AllenNeuralDynamics/harp.device.treadmill/hardware/board/treadmill_linear_brake_driver.asc

B1: bv; V=V(Vsns+, Vsns-)*200
C1: cap; 10n
D1: diode
L1: ind; 1m
M1: nmos; Si7336ADP
R1: res; 10
R2: res; 80m
R3: res; 7.5k
R4: res; 115
R6: res; 5.1k
U1: UniversalOpamp2; Avol=1.5Meg GBW=24Meg Slew=12Meg
V1: voltage; 12
V2: voltage; PULSE(.8 1.6 2m 100u 100u 200u 200u 4)
V3: voltage; 5
Named nets: 0, Vsns+, Vsns-, +5V
INA180A4 Simplified Model
.tran 50m startup
Brake model
DAC from MCU
for setpoint
