AllenNeuralDynamics/harp.device.treadmill/hardware/board/harp_treadmill.kicad_pcb

## KiCad design hardware/board/harp_treadmill.kicad_pcb (2025-09-08)

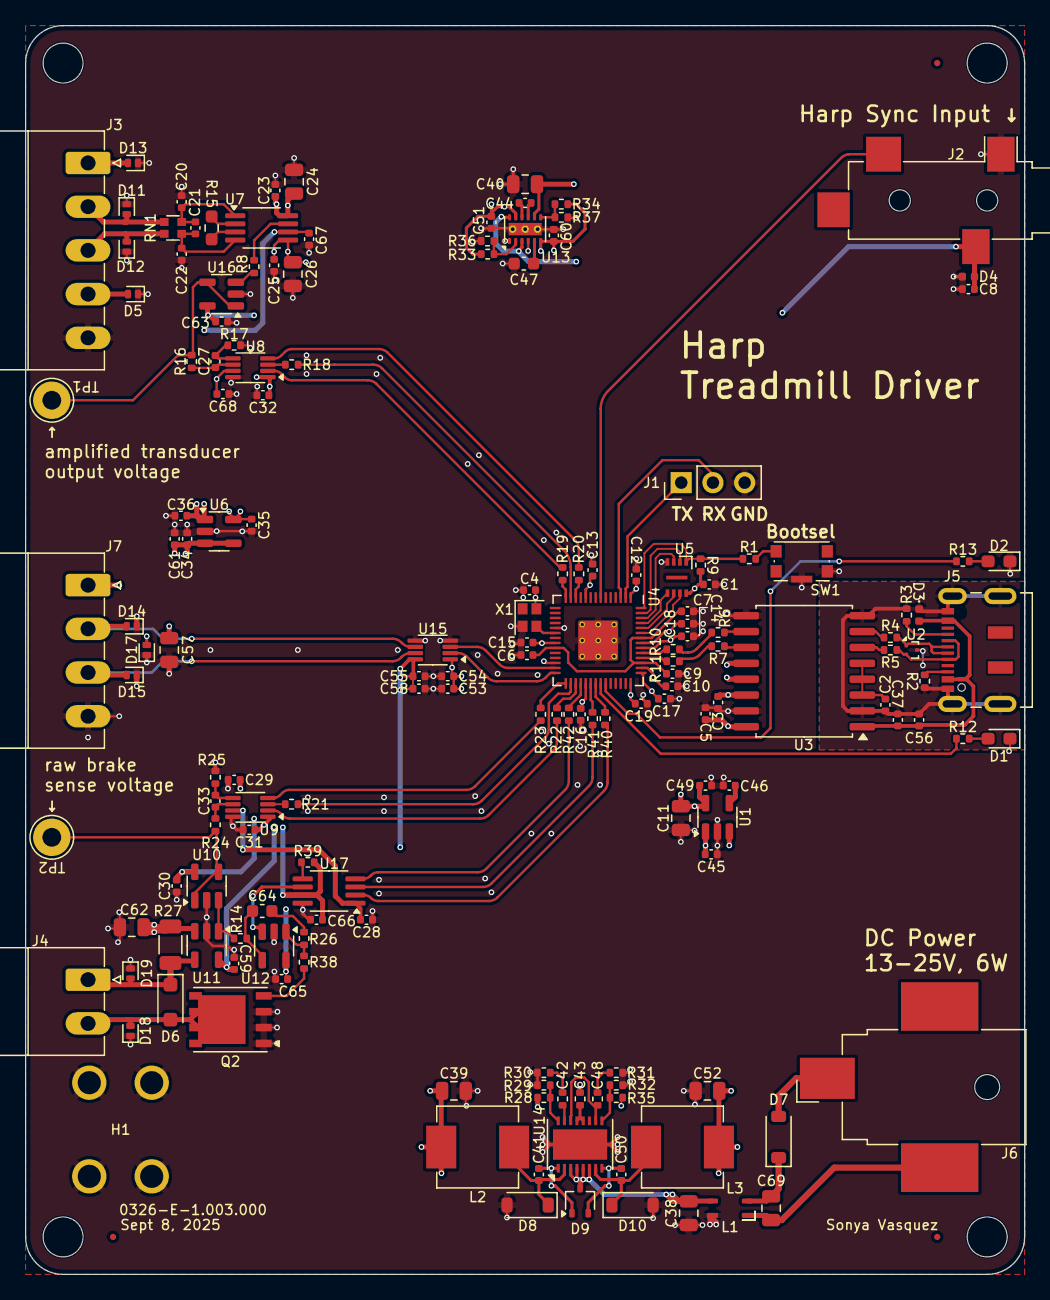
[picture p1: board harp_treadmill.kicad_pcb from above]

Board: 4 copper layers, 80.0 x 100.0 mm, 166 parts (0 on the bottom side), 105 nets.

Parts:
C1, C2, C3, C5, C6, C7, C12, C13, C14, C15, C16, C17, C18, C19, C23, C25, C28, C29, C30, C31, C32, C34, C35, C36, C37, C41, C50, C53, C58, C59, C63, C65, C66, C67, C68: 100nF; C_0402_1005Metric
C4, C46: 10nF; C_0402_1005Metric
C8, C9, C10, C44, C45, C54, C55, C56, C61: 1uF; C_0402_1005Metric
C11, C24, C26, C38, C57, C62, C69: 10uF; C_0805_2012Metric
C20, C22: 100pF; C_0402_1005Metric
C21: 1000pF; C_0402_1005Metric
C27, C33: 300pF; C_0402_1005Metric
C39, C40, C52: 22uF; C_0805_2012Metric
C42, C48: 1.5nF; R_0402_1005Metric
C43: 4.7nF; R_0402_1005Metric
C47: 4.7uF; C_0603_1608Metric
C49, C51, C60: 2.2uF; C_0402_1005Metric
C64: 10nF; C_0603_1608Metric
D1, D2: LED; LED_0603_1608Metric_Pad1.05x0.95mm_HandSolder
D3, D4: D_TVS; D_0402_1005Metric
D5, D11, D12, D13, D14, D15, D17, D18, D19: D_TVS; D_SOD-882D
D6: 1N4007FL; D_SOD-123F
D7, D8, D10: D_Schottky; D_SOD-123
D9: BAT54AW; SOT-323_SC-70
FID1, FID2, FID3: Fiducial; Fiducial_0.5mm_Mask1mm
H1: MountingHole_Pad; Terminal_Keystone_779x_EdgeMount_Horizontal
J1: Conn_01x03_Male; PinHeader_1x03_P2.54mm_Vertical
J2: AudioJack3; Jack_3.5mm_CUI_SJ-3524-SMT_Horizontal
J3: Conn_01x05_Female; PhoenixContact_MC_1,5_5-G-3.5_1x05_P3.50mm_Horizontal
J4: Conn_01x02_Female; PhoenixContact_MC_1,5_2-G-3.5_1x02_P3.50mm_Horizontal
J5: USB_C_Receptacle_USB2.0; USB_C_Receptacle_JAE_DX07S016JA1R1500
J6: Barrel_Jack_Switch; BarrelJack_CUI_PJ-036AH-SMT_Horizontal
J7: Conn_01x04_Female; PhoenixContact_MC_1,5_4-G-3.5_1x04_P3.50mm_Horizontal
L1: L_Coupled_1423; L_CommonModeChoke_TDKCorporation_1210
L2, L3: 10uH; L_Vishay_IHLP-2525
Q2: Si7336ADP; PowerPAK_SO-8_Single
R1: 1K; R_0402_1005Metric
R2, R3, R26: 5K1; R_0402_1005Metric
R4, R5, R6, R7: 24; R_0402_1005Metric
R8, R9, R28, R30, R31, R35, R39: 10K; R_0402_1005Metric
R10, R11: 27; R_0402_1005Metric
R12, R13: 680; R_0402_1005Metric
R14: 7K5; R_0402_1005Metric
R15: 499; R_0603_1608Metric_Pad0.98x0.95mm_HandSolder
R16, R17, R24, R25: 100; R_0402_1005Metric
R18, R19, R20, R21, R22, R23, R40, R41, R42: 49.9; R_0402_1005Metric
R27: 0.08; R_1206_3216Metric
R29: 715; R_0402_1005Metric
R32: 1K82; R_0402_1005Metric
R33: 162K; R_0402_1005Metric
R34: 158K; R_0402_1005Metric
R36, R37: 51K; R_0402_1005Metric
R38: 10; R_0402_1005Metric
RN1: 20K; R_Array_Convex_2x0606
SW1: SW_Push_1P1T-SH_NO_Vertical_Wuerth_WS-TASV
TP1, TP2: TestPoint; TestPoint_THTPad_D3.0mm_Drill1.5mm
U1: LP2985-3.3; SOT-23-5
U2: TPD2EUSB30; Texas_DRT-3
U3: ADUM4160; SOIC-16W_7.5x10.3mm_P1.27mm
U4: RP2040; RP2040-QFN-56
U5: W25Q16JVUXIQ; Winbond-8USON-2x3mm
U6: REF2033; SOT-23-5
U7: AD8226; MSOP-8_3x3mm_P0.65mm
U8, U9: ADS7049; VSSOP-8_2.3x2mm_P0.5mm
U10, U12, U16: AD8615; TSOT-23-5
U11: INA180A4; SOT-23-5
U13: LM27762; WSON-12-1EP_3x2mm_P0.5mm_EP1x2.65_ThermalVias
U14: LT3506; DFN-16-1EP_4x5mm_P0.5mm_EP2.44x4.34mm
U15: 74LVCH2T45DC; VSSOP-8_2.3x2mm_P0.5mm
U17: LTC2641; MSOP-8_3x3mm_P0.65mm
X1: ECS-TXO-2016; Crystal_SMD_2016-4Pin_2.0x1.6mm

Connections:
5V2: C34.2, C40.1, C45.1, C52.1, C55.1, C57.1, C58.2, C61.1, C65.2, D17.2 (A2), J7.1, L3.2, R35.1, U1.1 (VIN), U1.3 (ON/~OFF), U6.3 (EN), U6.4 (VIN), U12.5 (V+), U13.3 (VIN), U13.8 (EN-), U13.12 (EN+), U15.8 (VCCB)
+1V1: C6.2, C7.2, C9.1, U4.23 (DVDD), U4.45 (VREG_VOUT), U4.50 (DVDD)
+3V3: C1.2, C3.2, C4.2, C5.2, C8.1, C10.1, C11.1, C12.2, C13.2, C14.2, C15.2, C16.2, C17.2, C18.2, C19.2, C30.2, C31.2, C32.2, C49.2, C53.2, C54.1, C59.2, C63.2, C66.2, D4.2 (A2), J2.R, R9.2, R39.2, U1.5 (VOUT), U3.12 (PIN), U3.13 (SPD), U3.14 (VDD2), U3.16 (VBUS2), U4.1 (IOVDD), U4.10 (IOVDD), U4.22 (IOVDD), U4.26 (RUN), U4.33 (IOVDD), U4.42 (IOVDD), U4.43 (ADC_AVDD), U4.44 (VREG_IN), U4.48 (USB_VDD), U4.49 (IOVDD), U5.8 (VCC), U8.1 (DVDD), U9.1 (DVDD), U10.5 (V+), U11.5 (V+), U15.1 (VCCA), U16.5 (V+), U17.7 (VDD), X1.4 (VDD)
+5V: C23.2, C24.1, C51.2, D13.2 (A2), J3.1, R33.1, U7.8 (V+), U13.11 (OUT+)
+12V: C39.1, C62.1, L2.1, R27.1, R28.2, U11.3 (+)
-5V: C25.2, C26.2, C60.2, D5.2 (A2), J3.4, R34.1, U7.5 (V-), U13.6 (OUT-)
/Encoder/ENC_A: U4.27 (GPIO16), U15.3 (2A)
/Encoder/ENC_B: U4.28 (GPIO17), U15.2 (1A)
/Harp Core RP2040 + Isolated USB/D+: J5.A6 (D+), J5.B6 (D+), R4.1, U2.1 (D+)
/Harp Core RP2040 + Isolated USB/D-: J5.A7 (D-), J5.B7 (D-), R5.1, U2.2 (D-)
/Harp Core RP2040 + Isolated USB/DD+: R6.2, R10.2
/Harp Core RP2040 + Isolated USB/DD-: R7.2, R11.2
/Harp Core RP2040 + Isolated USB/HARP_CLK_SYNC: J2.T, U4.7 (GPIO5)
/Harp Core RP2040 + Isolated USB/PIO_ADC0_CS: R23.2, U4.29 (GPIO18)
/Harp Core RP2040 + Isolated USB/PIO_ADC0_POCI: R21.2, U4.30 (GPIO19)
/Harp Core RP2040 + Isolated USB/PIO_ADC0_SCK: R22.2, U4.31 (GPIO20)
/Harp Core RP2040 + Isolated USB/PIO_ADC1_CS: R20.2, U4.12 (GPIO9)
/Harp Core RP2040 + Isolated USB/PIO_ADC1_POCI: R18.2, U4.13 (GPIO10)
/Harp Core RP2040 + Isolated USB/PIO_ADC1_SCK: R19.2, U4.14 (GPIO11)
/Harp Core RP2040 + Isolated USB/PIO_DAC_CS: R40.2, U4.35 (GPIO23)
/Harp Core RP2040 + Isolated USB/PIO_DAC_PICO: R42.2, U4.32 (GPIO21)
/Harp Core RP2040 + Isolated USB/PIO_DAC_SCK: R41.2, U4.34 (GPIO22)
/Harp Core RP2040 + Isolated USB/QSPI_CLK: U4.52 (QSPI_SCLK), U5.6 (CLK)
/Harp Core RP2040 + Isolated USB/QSPI_CS: R1.2, R9.1, U4.56 (QSPI_SS), U5.1 (~CS)
/Harp Core RP2040 + Isolated USB/QSPI_D0: U4.53 (QSPI_SD0), U5.5 (DI(IO0))
/Harp Core RP2040 + Isolated USB/QSPI_D1: U4.55 (QSPI_SD1), U5.2 (DO(IO1))
/Harp Core RP2040 + Isolated USB/QSPI_D2: U4.54 (QSPI_SD2), U5.3 (IO2)
/Harp Core RP2040 + Isolated USB/QSPI_D3: U4.51 (QSPI_SD3), U5.7 (IO3)
/Harp Core RP2040 + Isolated USB/UART0_RXD: J1.2, U4.3 (GPIO1)
/Harp Core RP2040 + Isolated USB/UART0_TXD: J1.1, U4.2 (GPIO0)
/Harp Core RP2040 + Isolated USB/USB_Boot: R1.1, SW1.2
/Harp Core RP2040 + Isolated USB/VDD1: C2.2, U3.3 (VDD1), U3.4 (PDEN), U3.5 (SPU)
GND: C1.1, C3.1, C4.1, C5.1, C6.1, C7.1, C8.2, C9.2, C10.2, C11.2, C12.1, C13.1, C14.1, C15.1, C16.1, C17.1, C18.1, C19.1, C20.1, C22.2, C23.1, C24.2, C25.1, C26.1, C28.1, C29.1, C30.1, C31.1, C32.1, C34.1, C35.1, C36.1, C38.2, C39.2, C40.2, C43.1, C45.2, C46.2, C47.2, C49.1, C51.1, C52.2, C53.1, C54.2, C55.2, C57.2, C58.1, C59.1, C60.1, C61.2, C62.2, C63.1, C65.1, C66.1, C67.1, C68.1, D1.1 (K), D2.1 (K), D4.1 (A1), D5.1 (A1), D8.2 (A), D10.2 (A), D11.1 (A1), D12.1 (A1), D13.1 (A1), D14.1 (A1), D15.1 (A1), D17.1 (A1), D18.1 (A1), D19.1 (A1), H1.1, J1.3, J2.S, J3.5, J7.4, L1.4, Q2.1 (S), Q2.2 (S), Q2.3 (S), R17.1, R25.1, R29.2, R30.1, R31.1, R32.1, R36.2, R37.2, SW1.4, SW1.SH, U1.2 (GND), U3.9 (GND2), U3.15 (GND2), U4.19 (TESTEN), U4.57 (GND), U5.4 (GND), U6.2 (GND), U8.8 (GND), U9.8 (GND), U10.2 (V-), U11.2 (GND), U12.2 (V-), U13.1 (PGOOD), U13.4 (GND), U13.13 (PAD), U14.17 (GND), U15.4 (GND), U15.5 (DIR), U16.2 (V-), U17.8 (GND), X1.2 (GND)
GND1: C2.1, C37.1, C56.2, D3.1 (A1), J5.A1 (GND), J5.A12 (GND), J5.B1 (GND), J5.B12 (GND), J5.S1 (SHIELD), R2.2, R3.2, U2.3 (GND), U3.2 (GND1), U3.8 (GND1)
GND2: C69.2, J6.2, L1.1
unnamed: C42.1, R30.2
unnamed: C48.2, R31.2
unnamed: C64.2, R26.1
unnamed: D1.2 (A), R12.2
unnamed: D2.2 (A), R13.2
unnamed: C69.1, D7.1 (K), L1.2
unnamed: C41.1, D8.1 (K), L2.2, U14.2 (SW1)
unnamed: C50.1, D10.1 (K), L3.1, U14.7 (SW2)
unnamed: D11.2 (A2), J3.2, RN1.1 (R1.1)
unnamed: D12.2 (A2), J3.3, RN1.2 (R2.1)
unnamed: D14.2 (A2), J7.2, U15.6 (2B)
unnamed: D15.2 (A2), J7.3, U15.7 (1B)
unnamed: D6.2 (A), D18.2 (A2), J4.2, Q2.5 (D)
unnamed: D6.1 (K), D19.2 (A2), J4.1, R27.2, U11.4 (-)
unnamed: J5.A5 (CC1), R2.1
unnamed: J5.B5 (CC2), R3.1
unnamed: Q2.4 (G), R38.2
unnamed: R15.1, U7.2 (RG)
unnamed: R15.2, U7.3 (RG)
unnamed: R26.2, R38.1, U12.1
unnamed: C20.2, C21.1, RN1.4 (R1.2), U7.1 (IN-)
unnamed: C21.2, C22.1, RN1.3 (R2.2), U7.4 (IN+)
unnamed: C46.1, U1.4 (BP)
unnamed: R6.1, U3.10 (DD+)
unnamed: R7.1, U3.11 (DD-)
unnamed: R4.2, U3.7 (UD+)
unnamed: R5.2, U3.6 (UD-)
unnamed: R12.1, U4.36 (GPIO24)
unnamed: R13.1, U4.37 (GPIO25)
unnamed: R11.1, U4.46 (USB_DM)
unnamed: R10.1, U4.47 (USB_DP)
unnamed: U4.20 (XIN), X1.3 (OUT)
unnamed: R8.2, U7.7 (VOUT)
unnamed: C27.2, R17.2, U8.5 (AINM)
unnamed: C27.1, R16.1, U8.6 (AINP)
unnamed: R19.1, U8.2 (SCLK)
unnamed: R18.1, U8.3 (SDO)
unnamed: R20.1, U8.4 (~CS)
unnamed: C33.2, R25.2, U9.5 (AINM)
unnamed: C33.1, R24.1, U9.6 (AINP)
unnamed: R22.1, U9.2 (SCLK)
unnamed: R21.1, U9.3 (SDO)
unnamed: R23.1, U9.4 (~CS)
unnamed: R14.1, U10.3 (+), U11.1
unnamed: R24.2, TP2.1, U10.1, U10.4 (-)
unnamed: U12.3 (+), U17.6 (VOUT)
unnamed: C64.1, R14.2, U12.4 (-)
unnamed: C44.1, U13.10 (C+)
unnamed: C44.2, U13.9 (C-)
unnamed: C47.1, U13.5 (CP)
unnamed: R33.2, R36.1, U13.2 (FB+)
unnamed: R34.2, R37.1, U13.7 (FB-)
unnamed: C41.2, D9.1, U14.1 (BOOST1)
unnamed: C50.2, D9.2, U14.8 (BOOST2)
unnamed: R28.1, R29.1, U14.16 (FB1)
unnamed: R32.2, R35.2, U14.9 (FB2)
unnamed: C48.1, U14.10 (VC2), U14.14 (PG1)
unnamed: C43.2, U14.12 (RUN/SS2), U14.13 (RUN/SS1)
unnamed: C42.2, U14.15 (VC1)
unnamed: R8.1, U16.3 (+)
unnamed: R16.2, TP1.1, U16.1, U16.4 (-)
unnamed: R42.1, U17.4 (DIN)
unnamed: R41.1, U17.3 (SCLK)
unnamed: R39.1, U17.5 (~CLR)
unnamed: R40.1, U17.2 (~CS)
VBUS: C37.2, C56.1, D3.2 (A2), J5.A4 (VBUS), J5.A9 (VBUS), J5.B4 (VBUS), J5.B9 (VBUS), U3.1 (VBUS1)
VIN1: C38.1, D9.3, L1.3, U14.3 (VIN1), U14.4 (VIN1), U14.5 (VIN2), U14.6 (VIN2)
VPP: D7.2 (A), J6.1
VREF_1V65: C36.2, C67.2, U6.1 (VBIAS), U7.6 (REF)
VREF_3V3: C28.2, C29.2, C35.2, C68.2, U6.5 (VREF), U8.7 (AVDD), U9.7 (AVDD), U17.1 (REF)
