AllenNeuralDynamics/harp.device.treadmill/(threads)

Thread 2 (2023-04-10):

Make cloning pico-sdk optional if already installed

Poofjunior, 2023-04-10:
The pico-sdk has a fairly heavy footprint (on the order of gigabytes).

We should enable some sort of option to not need to clone the pico-sdk if the user can specify its location elsewhere. We could do this with some sort of environment variable definition, like `$PICO_SDK_DIR`, that gets checked beforehand.

Poofjunior, 2023-12-22:
This is addressed in the insructions, and the pico-sdk submodule has been removed.

Closed 2023-12-22.

Thread 3 (2023-12-06):

Implement LTC264x pio driver

Poofjunior, 2023-12-06:
We should be able to:
* write a new 16-bit value to it (i.e: put something in the TXFIFO).
* dispatch the value over SPI.

Poofjunior, 2023-12-14:
done.

Poofjunior, 2025-04-22:
Driver has been split into its own repository here: https://github.com/AllenNeuralDynamics/rp2040.pio-ltc264x

Closed 2025-04-22.

Thread 4 (2023-12-08):

Tease PIO_ADS70x9 into its own repo

Poofjunior, 2023-12-08:
This driver is copy-pasted into two different repos: this one and the [lickety split repo](https://github.com/AllenNeuralDynamics/harp.device.lickety-split/tree/main) (bad!). Let's tease this device into its own repo that can be submoduled and compiled into other projects like the Harp Core.

Poofjunior, 2023-12-08:
Started: https://github.com/AllenNeuralDynamics/rp2040.pio-ads7049

Closed 2023-12-11.

Thread 5 (2023-12-12):

VREF is wrong for U9, U17

Poofjunior, 2023-12-12:
The voltage references for U9 and U17 should be 3.3V, not 1.65V.

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

Poofjunior, 2023-12-14:
It is possible to get the v0.1.0 board working by severing the 1.65 reference (on the bottom of the board) and then bodge-wiring the 3.3V reference.

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

Closed 2025-04-22.

Thread 8 (2023-12-21):

R16, R17 should be 127Ohm, 1/10W

Poofjunior, 2023-12-21:
As-is, the resistor wattage rating is a little low for the amount of current they could theoretically see. Let's bump this up to 127Ohm, 1/10W to be on the safe side.

Thread 9 (2023-12-22):

Validate Hot-Pluggability

Poofjunior, 2023-12-22:
Can the treadmill be hot-plugged? The use-case is to be able to install-and-remove the treadmill platform where the mechanical hardware, sensors, and brake are a single unit. This is currently going to be done with an electrical spring-based contact pins. We need to make sure every io pin (brake, encoder, transducer) can be unplugged or plugged-in with the device turned on without damaging anything.

Thread 10 (2023-12-23):

Resize treadmill PCB to meet enclosure worst-case tolerances

Poofjunior, 2023-12-23:
Currently, we use a Hammond Manufacturing 1455L802 enclosure ([drawing](https://www.hammfg.com/files/parts/pdf/1455L802.pdf)) for this project, but its worst-case tolerances are 99.5mm, which means our PCBs will be too big in some cases. We need to adjust our PCB to accomodate this worst-case dimension.

Thread 11 (2024-01-18):

Sensor readings should be configurable as periodic events

Poofjunior, 2024-01-18:
The Treadmill has 3 sensors:
* brake current
* encoder
* torque sensor torque

We should be able to dispatch these readings as periodic Harp Events at a configurable interval (up to 1 KHz).

bruno-f-cruz, 2024-03-09:
This one can be closed. Tested and working up to 1khz

Closed 2025-04-22.

Thread 12 (2024-01-24):

Treadmill should be able to self-check if it is connected to sensor/actuator

Poofjunior, 2024-01-24:
Since cables can be unplugged, it would be ideal to be able to check the presence of all sensors and actuators.

Practically, we might not be able to detect all devices, but checking as many as possible would be a good start.

Thread 14 (2024-02-27):

Make Encoder value resettable

Poofjunior, 2024-02-27:

bruno-f-cruz, 2024-03-09:
Tested and working!

Closed 2025-04-22.

Thread 15 (2024-02-27):

Desired Register set

Poofjunior, 2024-02-27:
* raw position
* raw torque (reaction torque from mouse)
* raw current (applied torque from brake)
* 5 register spaces
* aggregate register of the first 3 registers in an array: [raw position, raw torque, raw current]
* raw sensors dispatch rate hz
* current setpoint
* "tare" (position, current, torque)
* Error register
  *  brake disconnected
  * current setpoint and sensed current mismatch. (out of range)

bruno-f-cruz, 2024-03-06:
uint8_t tare;   // { unused[15:3], encoder[2], torque[1], brake_current[0]};
Can this be inverted to match the order of the registers? ie.:
encoder[0], torque[1], brake_current[2]

Poofjunior, 2024-03-06:
yes. I'll plan to make it:
* 16-bit
* `{unused[15:3], brake_current[2], torque[1], encoder[1]}`

bruno-f-cruz, 2024-03-09:
Can be closed. Tested and working!

Closed 2025-04-22.

Thread 24 (2025-04-22):

Consider TVS Diodes on all hot-plugged inputs

Poofjunior, 2025-04-22:
The current use case for this system involves hot-plugging all treadmill connections to add/remove a live mouse installed on the physical treadmill hardware. Unfortunately, doing so, may be causing a huge static discharge, causing *other* devices connected to the same PSU as this system to glitch and close serial port connections.

One solution to mitigate this issue would be to install TVS diodes on all inputs/outputs we are planning on hot-plugging. WE'd also likely want to add a flyback diode to the magnetic brake, which we could assume is an inductive load.

Here are the schematic connections that need to be altered. Note that some of them take up to 12V.

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

Thread 25 (2025-07-21):

Treadmill LM27762 Runs Hot

Poofjunior, 2025-07-21:
On this board, the LM27762 dual +5/-5 power supply chip is running much hotter than normal, causing the outside of the case to feel much warmer than other boards working normally.

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
